lucasexequiel/CEDCp_Modulo_Potencia/Módulo_Potencia_Esquematico.png

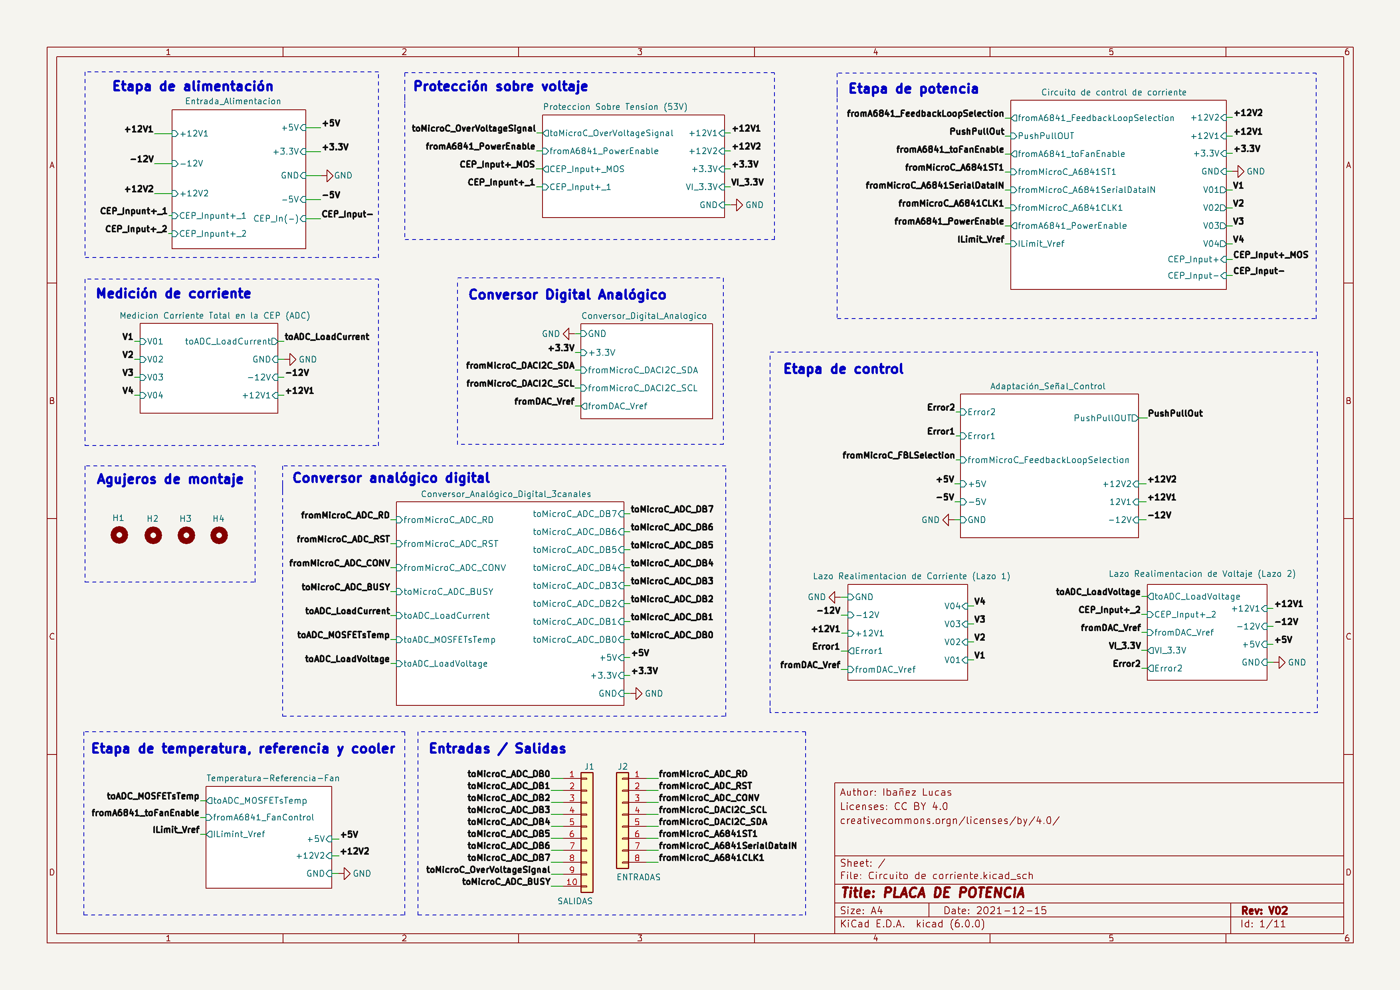
Módulo_Potencia_Esquematico.png
