lucasexequiel/CEDCp_Modulo_Potencia/Gerbers/Circuito de corriente-B_Cu_Page.pdf

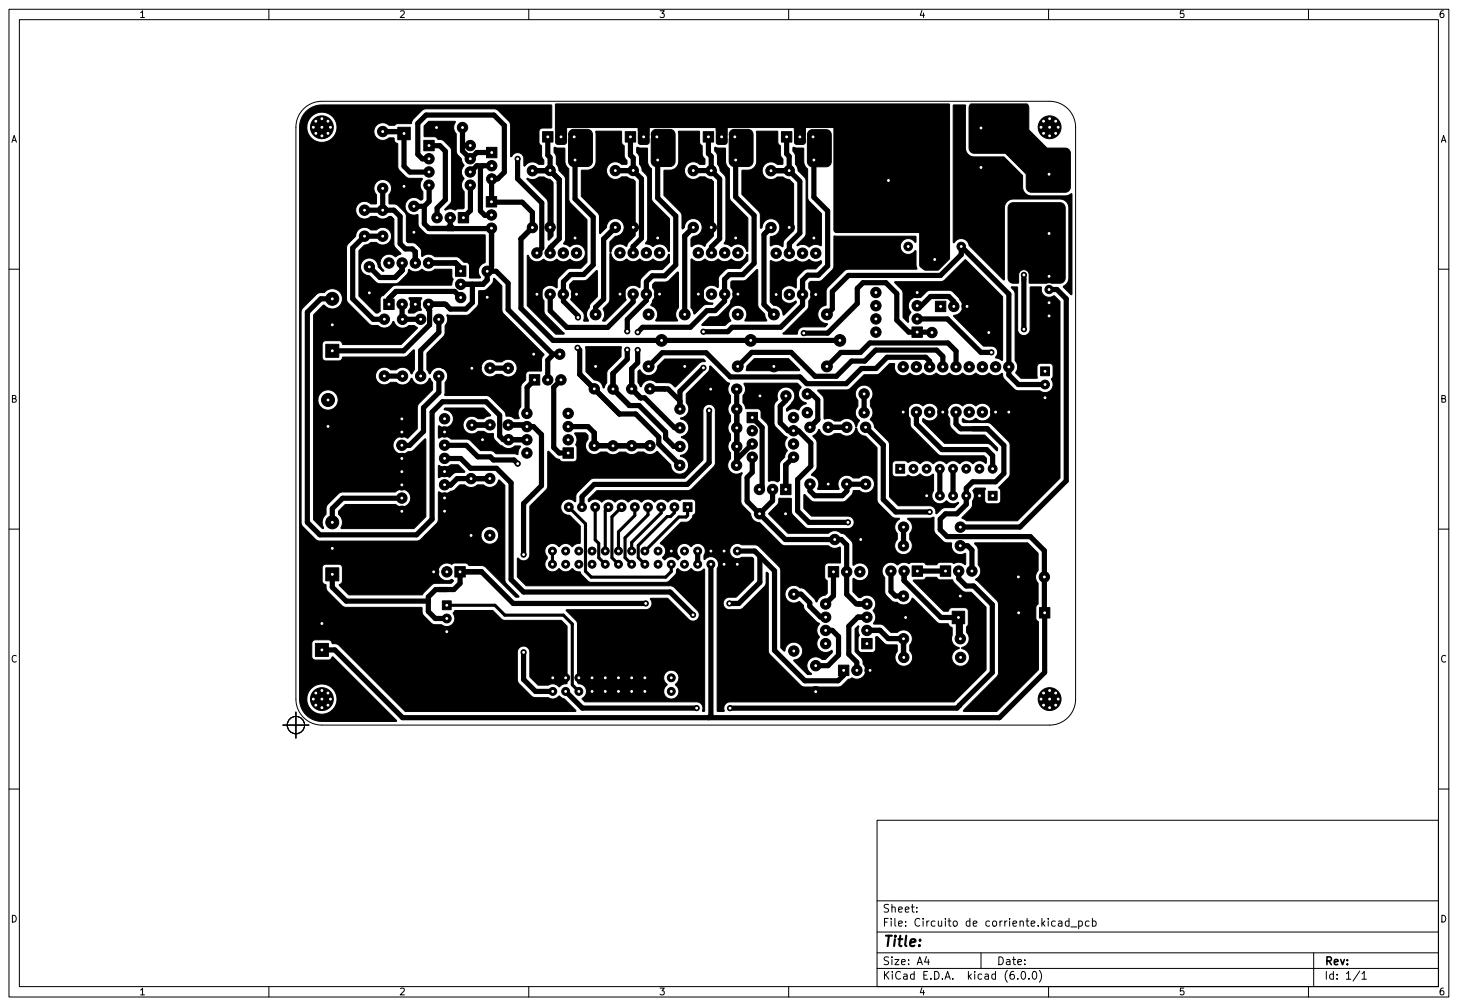
[picture p2: page 1]

File: Circuito de corriente.kicad_pcb Sheet:
Id: 1/1 Title:
