lucasexequiel/CEDCp_Modulo_Potencia/Gerbers/Circuito de corriente-B_Cu_0.pdf

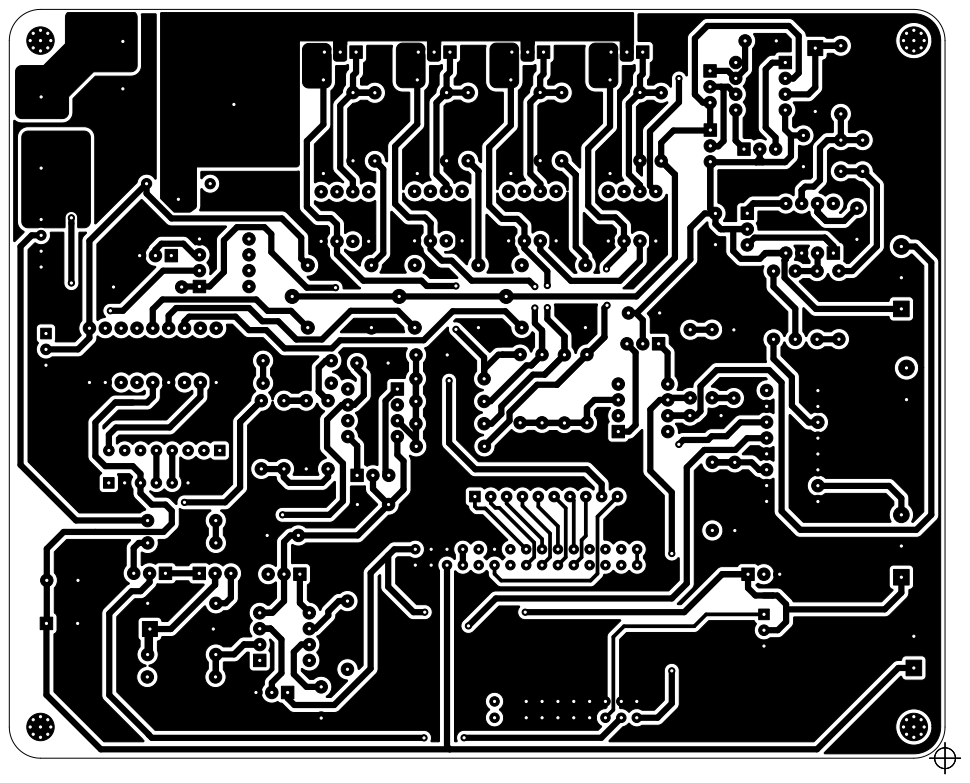
[picture p4: page 1]
