lucasexequiel/CEDCp_Modulo_Potencia/Gerbers/Circuito de corriente-F_Cu_0.pdf

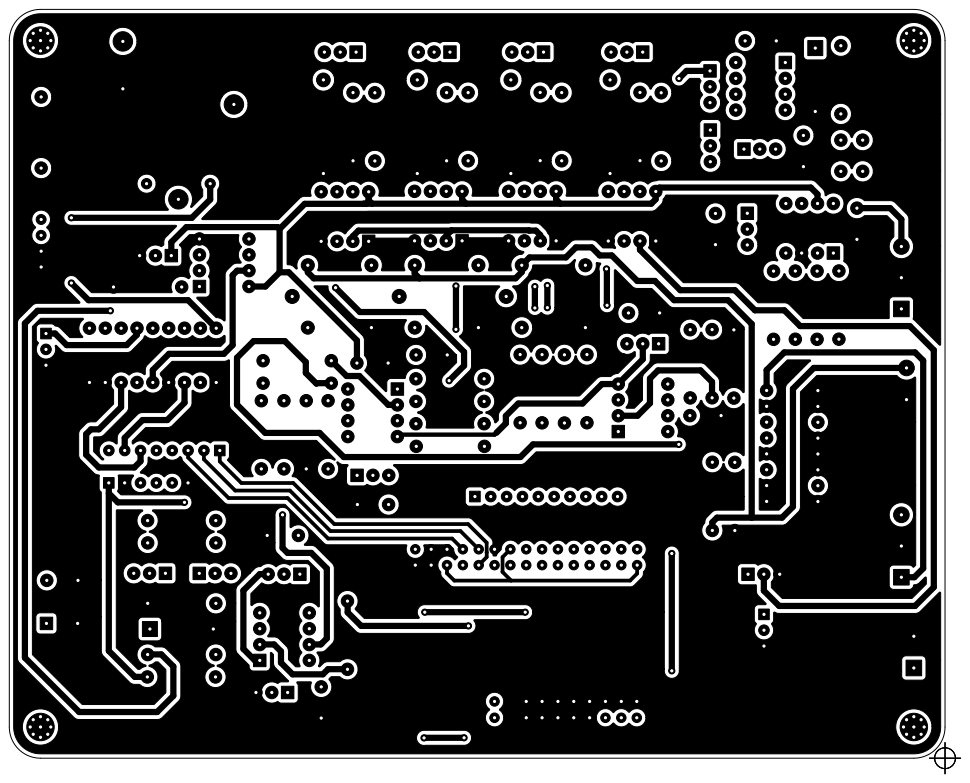
[picture p5: page 1]
