lucasexequiel/CEDCp_Modulo_Potencia/Circuito de corriente.kicad_pcb

## KiCad design Circuito de corriente.kicad_pcb (2022-05-04)

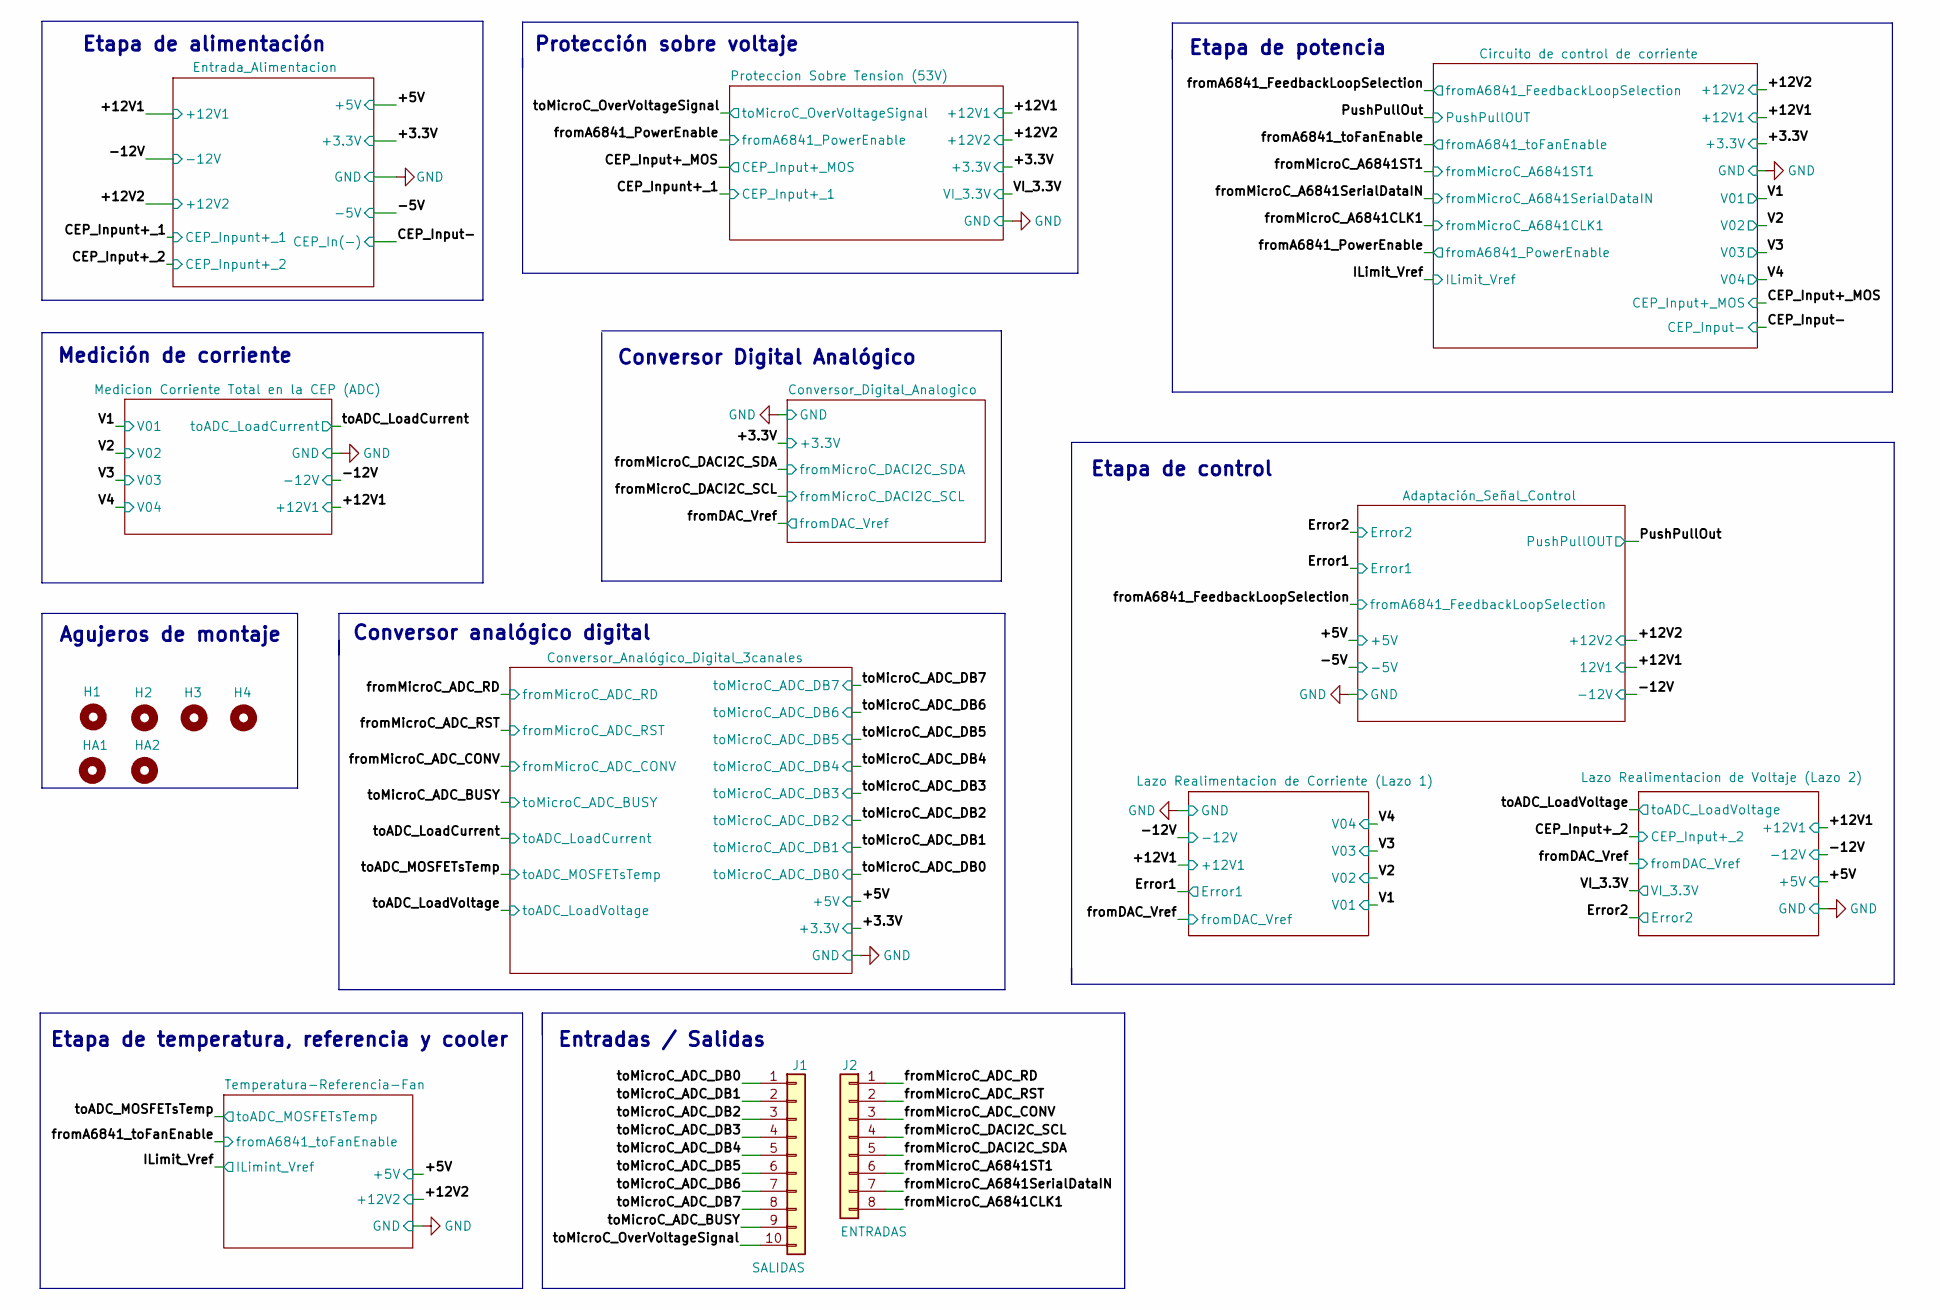
[picture p6: schematic Circuito de corriente.kicad_sch, PLACA DE POTENCIA]

Parts:
H1, H2, H3, H4: MountingHole; MountingHole_2.2mm_M2_Pad_Via
HA1, HA2: MountingHole; MountingHole_2.2mm_M2_Pad_Via
J1: SALIDAS; PinHeader_1x10_P2.54mm_Vertical
J2: ENTRADAS; PinHeader_1x08_P2.54mm_Vertical

Connections:
/fromMicroC_A6841CLK1: J2.8; also elsewhere on the board
/fromMicroC_A6841ST1: J2.6; also elsewhere on the board
/fromMicroC_A6841SerialDataIN: J2.7; also elsewhere on the board
/fromMicroC_ADC_CONV: J2.3; also elsewhere on the board
/fromMicroC_ADC_RD: J2.1; also elsewhere on the board
/fromMicroC_ADC_RST: J2.2; also elsewhere on the board
/fromMicroC_DACI2C_SCL: J2.4; also elsewhere on the board
/fromMicroC_DACI2C_SDA: J2.5; also elsewhere on the board
/toMicroC_ADC_BUSY: J1.9; also elsewhere on the board
/toMicroC_ADC_DB0: J1.1; also elsewhere on the board
/toMicroC_ADC_DB1: J1.2; also elsewhere on the board
/toMicroC_ADC_DB2: J1.3; also elsewhere on the board
/toMicroC_ADC_DB3: J1.4; also elsewhere on the board
/toMicroC_ADC_DB4: J1.5; also elsewhere on the board
/toMicroC_ADC_DB5: J1.6; also elsewhere on the board
/toMicroC_ADC_DB6: J1.7; also elsewhere on the board
/toMicroC_ADC_DB7: J1.8; also elsewhere on the board
/toMicroC_OverVoltageSignal: J1.10; also elsewhere on the board

Notes on the sheet:
Etapa de control
Agujeros de montaje
Etapa de temperatura, referencia y cooler
Protección sobre voltaje
Conversor Digital Analógico
Entradas / Salidas
Conversor analógico digital
Medición de corriente
Etapa de potencia
Etapa de alimentación

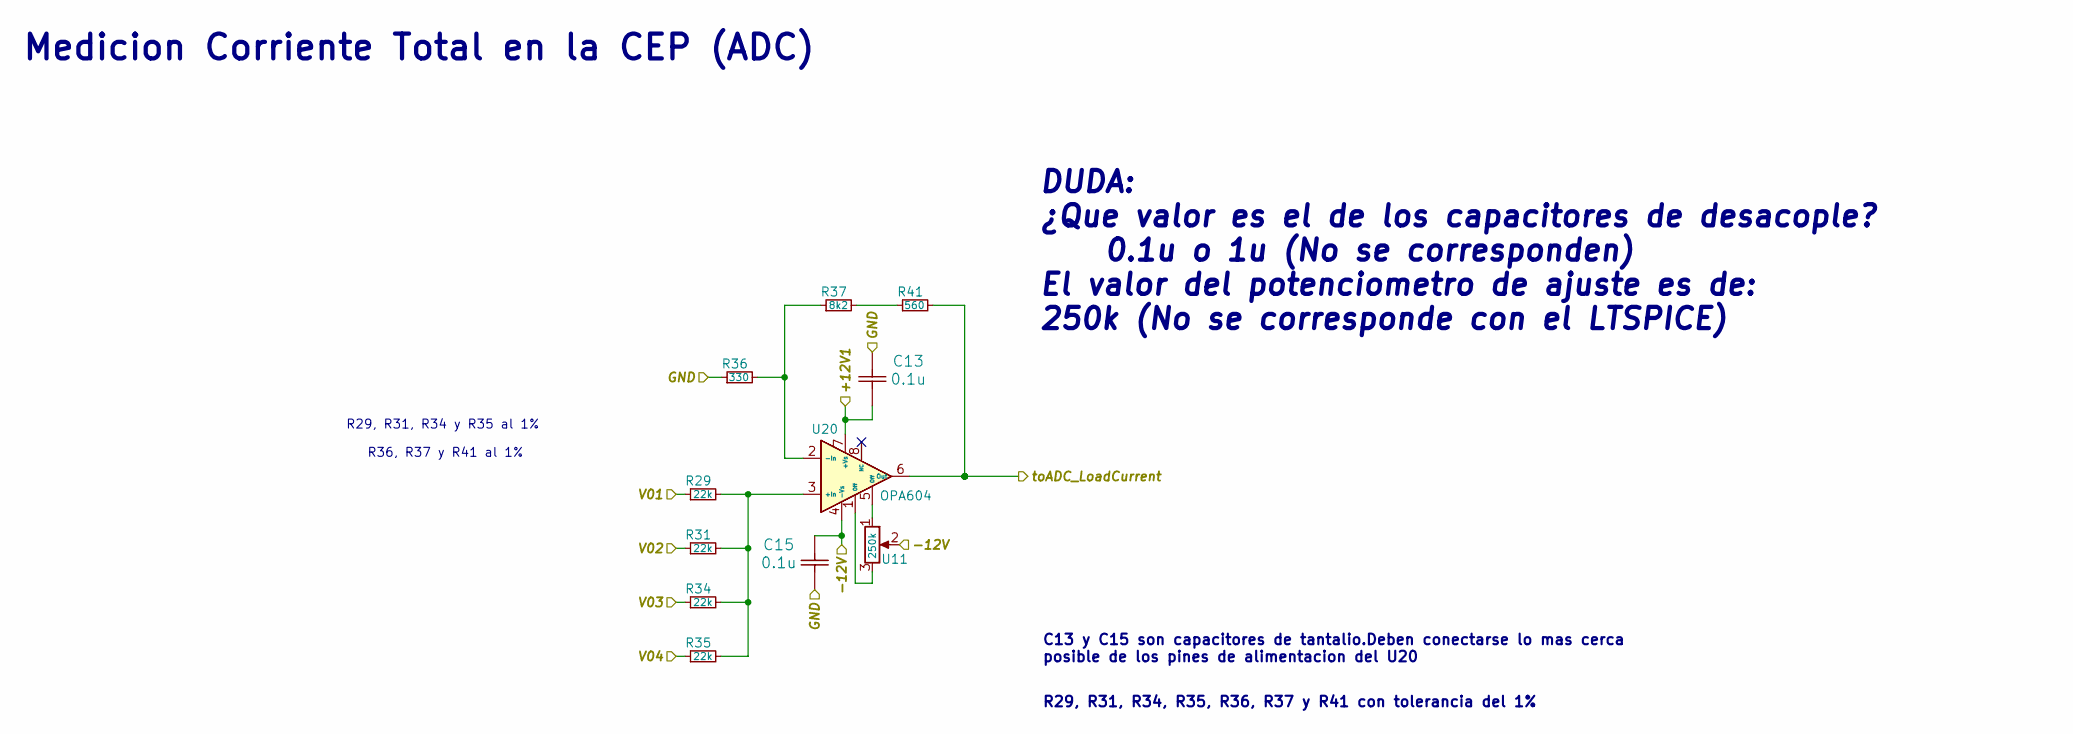
[picture p7: schematic Medicion Corriente Total en la CEP (ADC).kicad_sch]

Parts:
C13, C15: 0.1u; C_Disc_D7.5mm_W2.5mm_P5.00mm
R29, R31, R34, R35: 22k; Resistencia_0,25W
R36: 330; Resistencia_0,25W
R37: 8k2; Resistencia_0,25W
R41: 560; Resistencia_0,25W
U11: 250k; Preset_Multivueltas_Vertical
U20: OPA604

Connections:
/+12V1: C13.2, U20.7 (+Vs); also elsewhere on the board
/V1: R29.1; also elsewhere on the board
/V2: R31.1; also elsewhere on the board
/V3: R34.1; also elsewhere on the board
/V4: R35.1; also elsewhere on the board
/toADC_LoadCurrent: R41.2, U20.6 (Out); also elsewhere on the board
GND: C13.1, C15.2, R36.1; also elsewhere on the board
unnamed: R29.2, R31.2, R34.2, R35.2, U20.3 (+In)
unnamed: R36.2, R37.1, U20.2 (-In)
unnamed: R37.2, R41.1

Notes on the sheet:
R29, R31, R34, R35, R36, R37 y R41 con tolerancia del 1%
DUDA: ¿Que valor es el de los capacitores de desacople? 0.1u o 1u (No se corresponden) El valor del potenciometro de ajuste es de: 250k (No se corresponde con el LTSPICE)
R36, R37 y R41 al 1%
Medicion Corriente Total en la CEP (ADC)
C13 y C15 son capacitores de tantalio.Deben conectarse lo mas cerca posible de los pines de alimentacion del U20
R29, R31, R34 y R35 al 1%

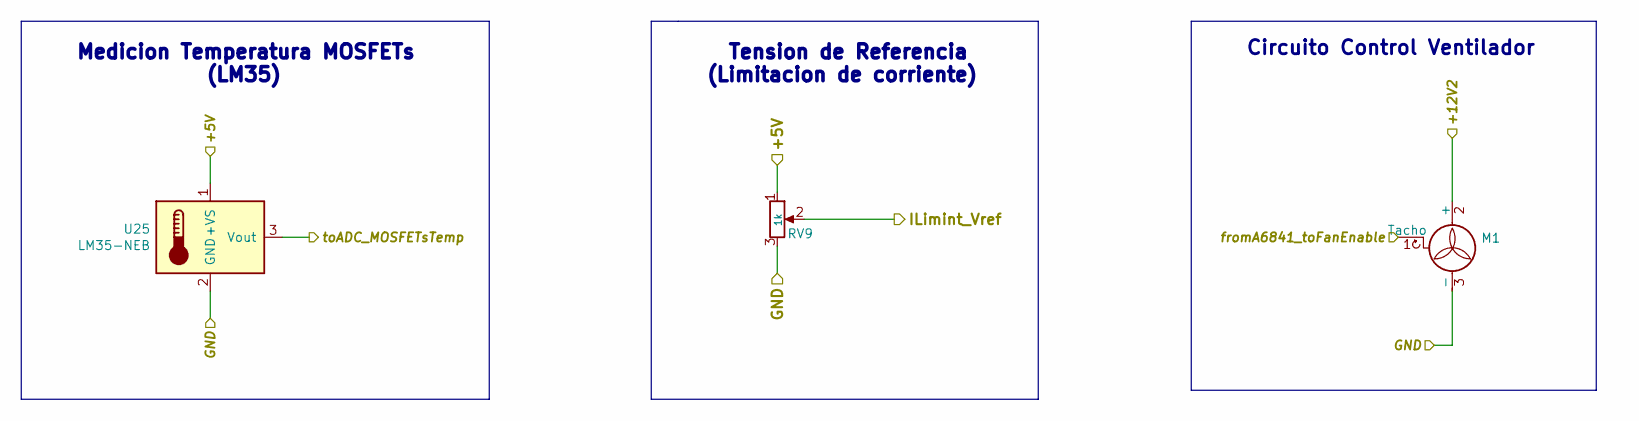
[picture p8: schematic Temperatura-Referencia-Fan.kicad_sch]

Parts:
M1: Fan_3pin; PinHeader_1x03_P2.54mm_Vertical
RV9: 1k; Preset_Multivueltas_Vertical
U25: LM35-NEB; PinHeader_1x03_P2.54mm_Vertical

Connections:
/+5V: RV9.1, U25.1 (+VS); also elsewhere on the board
/+12V2: M1.2 (+); also elsewhere on the board
/ILimit_Vref: RV9.2; also elsewhere on the board
/fromA6841_toFanEnable: M1.1 (Tacho); also elsewhere on the board
/toADC_MOSFETsTemp: U25.3 (Vout); also elsewhere on the board
GND: M1.3 (-), RV9.3, U25.2 (GND); also elsewhere on the board

Notes on the sheet:
Tension de Referencia (Limitacion de corriente)
Medicion Temperatura MOSFETs (LM35)
Circuito Control Ventilador

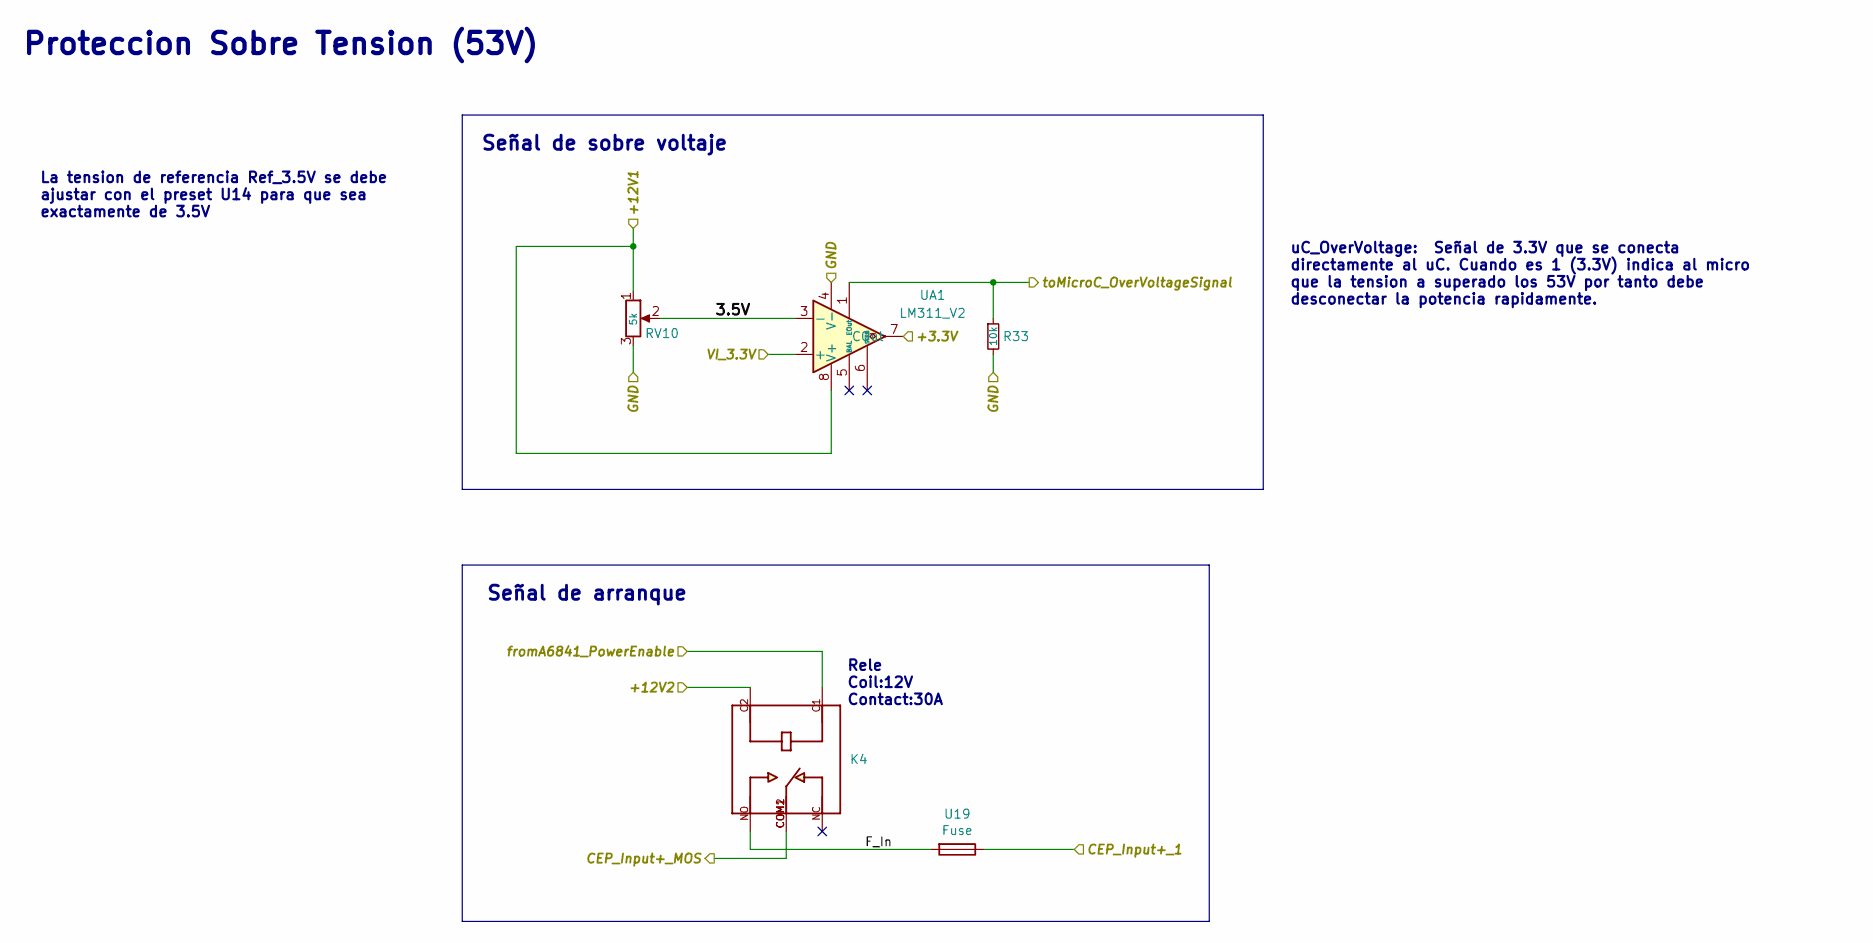
[picture p9: schematic Proteccion Sobre Tension (53V).kicad_sch]

Parts:
K4: SLA-12VDC-SL-C; RELE_30A
R33: 10k; Resistencia_0,25W
RV10: 5k; Preset_Multivueltas_Vertical
U19: Fuse
UA1: LM311_V2

Connections:
/+3.3V: UA1.7 (COut); also elsewhere on the board
/+12V1: RV10.1, UA1.8 (V+); also elsewhere on the board
/+12V2: K4.C2; also elsewhere on the board
/CEP_Inpunt+_1: U19.1; also elsewhere on the board
/CEP_Input+_MOS: K4.COM1, K4.COM2; also elsewhere on the board
/Proteccion Sobre Tension (53V)/3.5V: RV10.2, UA1.3 (-)
/Proteccion Sobre Tension (53V)/F_In: K4.NO, U19.2
/VI_3.3V: UA1.2 (+); also elsewhere on the board
/fromA6841_PowerEnable: K4.C1; also elsewhere on the board
/toMicroC_OverVoltageSignal: R33.1, UA1.1 (EOut); also elsewhere on the board
GND: R33.2, RV10.3, UA1.4 (V-); also elsewhere on the board

Notes on the sheet:
Señal de arranque
La tension de referencia Ref_3.5V se debe ajustar con el preset U14 para que sea exactamente de 3.5V
Rele Coil:12V Contact:30A
Proteccion Sobre Tension (53V)
uC_OverVoltage: Señal de 3.3V que se conecta directamente al uC. Cuando es 1 (3.3V) indica al micro que la tension a superado los 53V por tanto debe desconectar la potencia rapidamente.
Señal de sobre voltaje

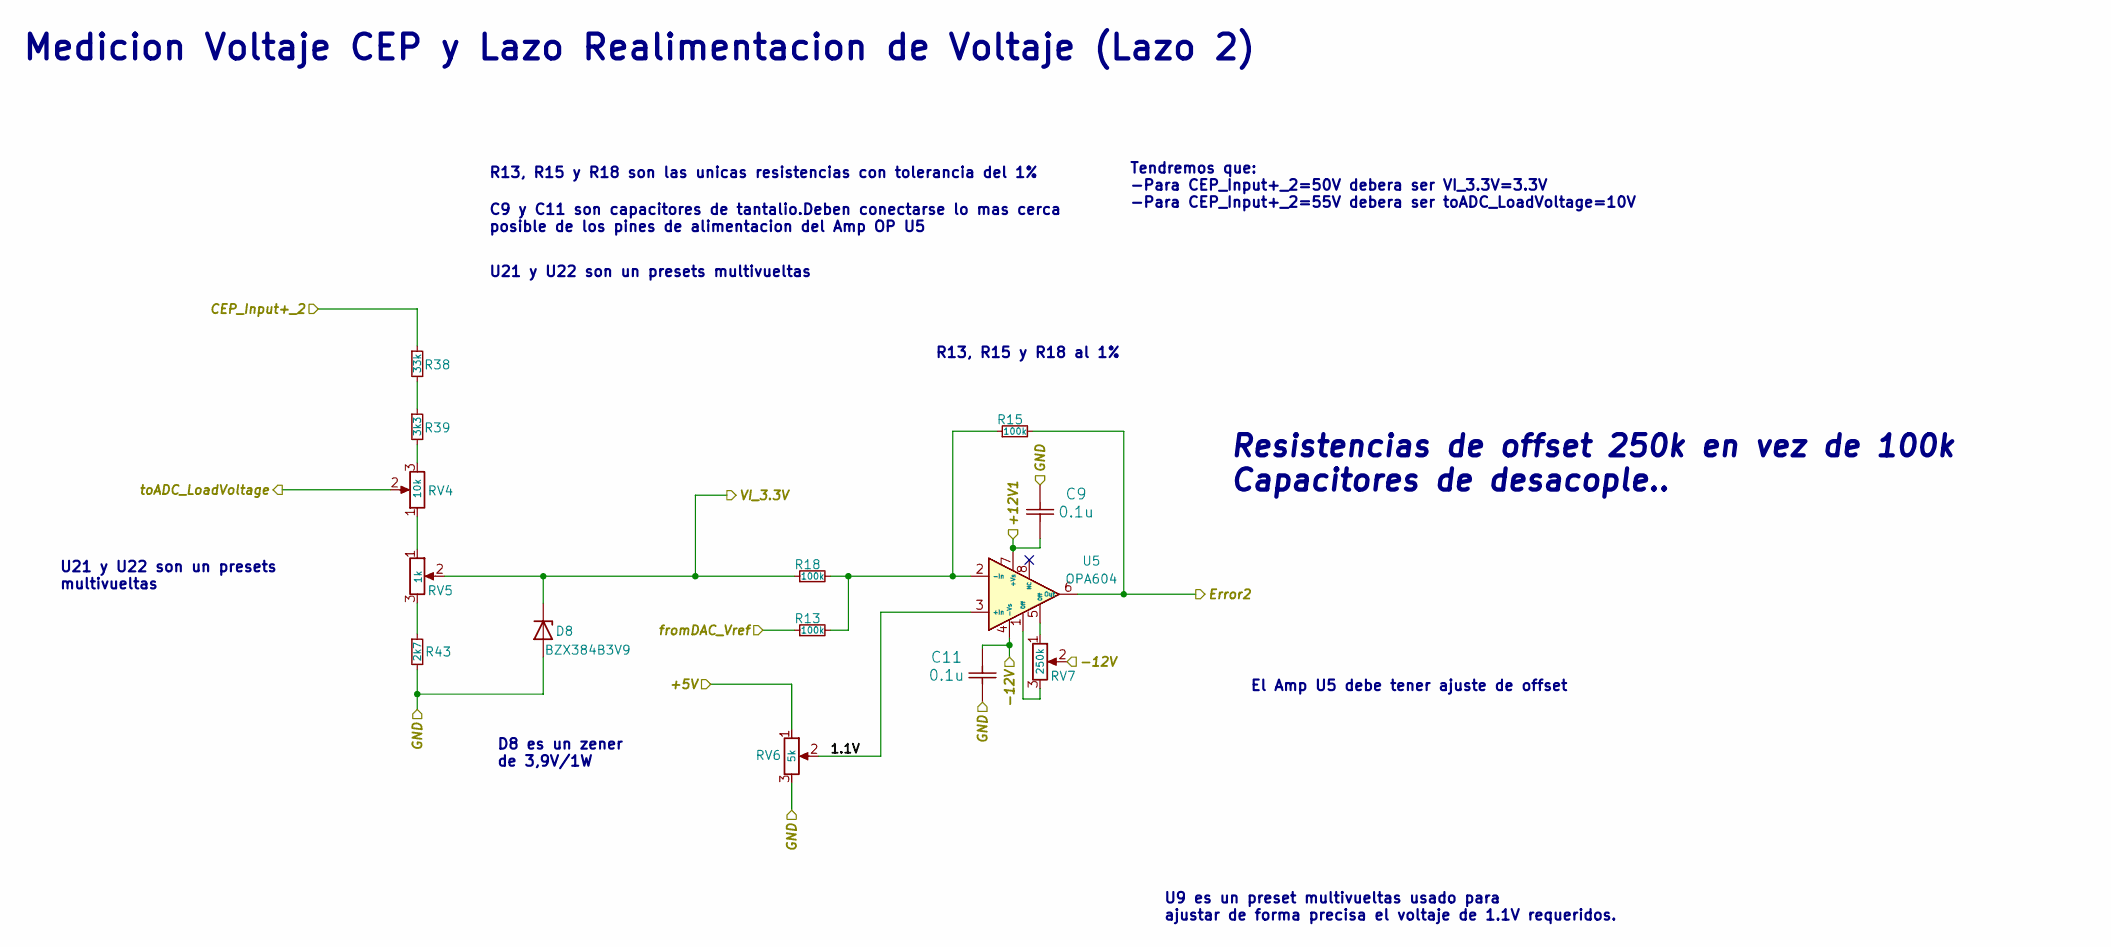
[picture p10: schematic Lazo Realimentacion de Voltaje (Lazo 2).kicad_sch]

Parts:
C9, C11: 0.1u; C_Disc_D7.5mm_W2.5mm_P5.00mm
D8: BZX384B3V9; D_DO-15_P10.16mm_Horizontal
R13, R15, R18: 100k; Resistencia_0,25W
R38: 33k; Resistencia_0,25W
R39: 3k3; Resistencia_0,25W
R43: 2k7; Resistencia_0,25W
RV4: 10k; Preset_Multivueltas_Vertical
RV5: 1k; Preset_Multivueltas_Vertical
RV6: 5k; Preset_Multivueltas_Vertical
RV7: 250k; Preset_Multivueltas_Vertical
U5: OPA604

Connections:
/+5V: RV6.1; also elsewhere on the board
/+12V1: C9.2, U5.7 (+Vs); also elsewhere on the board
/CEP_Input+_2: R38.1; also elsewhere on the board
/Error2: R15.2, U5.6 (Out); also elsewhere on the board
/Lazo Realimentacion de Voltaje (Lazo 2)/1.1V: RV6.2, U5.3 (+In)
/VI_3.3V: D8.1 (K), R18.1, RV5.2; also elsewhere on the board
/fromDAC_Vref: R13.1; also elsewhere on the board
/toADC_LoadVoltage: RV4.2; also elsewhere on the board
GND: C9.1, C11.1, D8.2 (A), R43.2, RV6.3; also elsewhere on the board
unnamed: R13.2, R15.1, R18.2, U5.2 (-In)
unnamed: R38.2, R39.1
unnamed: R39.2, RV4.3
unnamed: R43.1, RV5.3
unnamed: RV4.1, RV5.1
unnamed: RV7.1, U5.5 (Off)
unnamed: RV7.3, U5.1 (Off)

Notes on the sheet:
U9 es un preset multivueltas usado para ajustar de forma precisa el voltaje de 1.1V requeridos.
C9 y C11 son capacitores de tantalio.Deben conectarse lo mas cerca posible de los pines de alimentacion del Amp OP U5
El Amp U5 debe tener ajuste de offset
U21 y U22 son un presets multivueltas
D8 es un zener de 3,9V/1W
R13, R15 y R18 al 1%
Resistencias de offset 250k en vez de 100k Capacitores de desacople..
U21 y U22 son un presets multivueltas
Medicion Voltaje CEP y Lazo Realimentacion de Voltaje (Lazo 2)
Tendremos que: -Para CEP_Input+_2=50V debera ser VI_3.3V=3.3V -Para CEP_Input+_2=55V debera ser toADC_LoadVoltage=10V
R13, R15 y R18 son las unicas resistencias con tolerancia del 1%

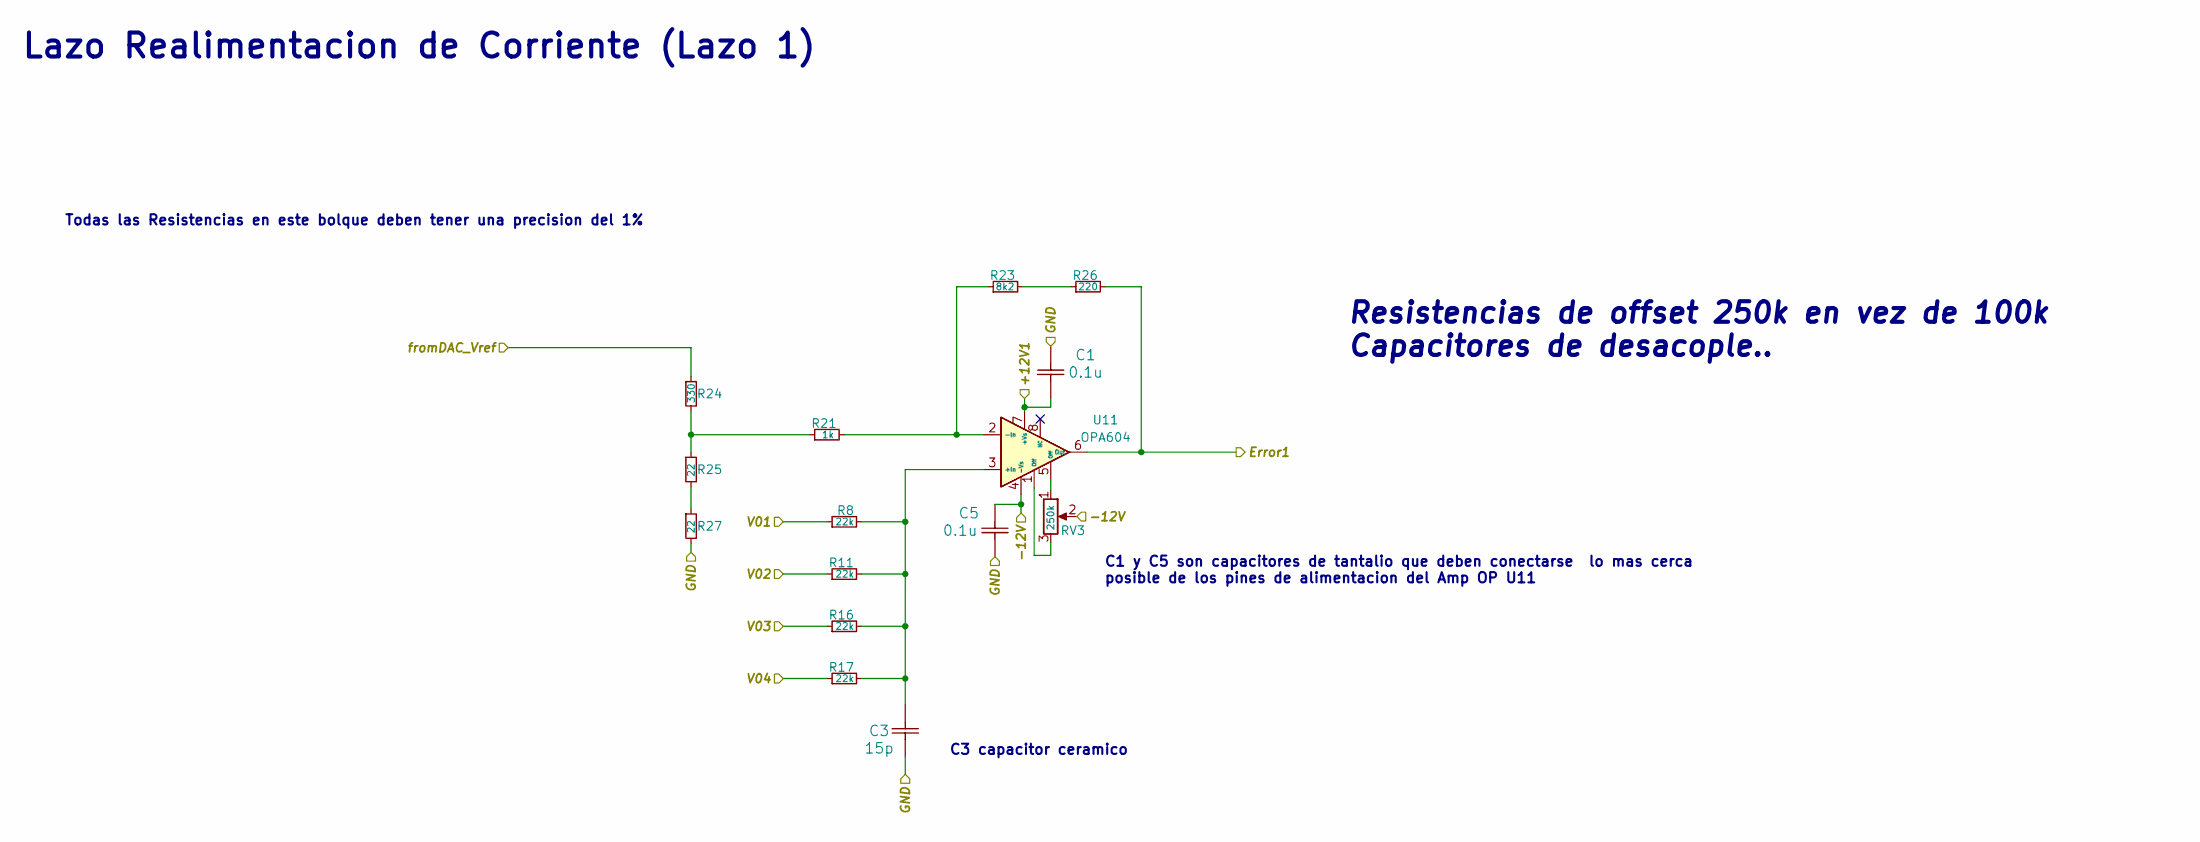
[picture p11: schematic Lazo Realimentacion de Corriente (Lazo 1).kicad_sch]

Parts:
C1, C5: 0.1u; C_Disc_D7.5mm_W2.5mm_P5.00mm
C3: 15p; C_Disc_D7.5mm_W2.5mm_P5.00mm
R8, R11, R16, R17: 22k; Resistencia_0,25W
R21: 1k; Resistencia_0,25W
R23: 8k2; Resistencia_0,25W
R24: 330; Resistencia_0,25W
R25, R27: 22; Resistencia_0,25W
R26: 220; Resistencia_0,25W
RV3: 250k; Preset_Multivueltas_Vertical
U11: OPA604

Connections:
/+12V1: C1.2, U11.7 (+Vs); also elsewhere on the board
/Error1: R26.2, U11.6 (Out); also elsewhere on the board
/V1: R8.1; also elsewhere on the board
/V2: R11.1; also elsewhere on the board
/V3: R16.1; also elsewhere on the board
/V4: R17.1; also elsewhere on the board
/fromDAC_Vref: R24.1; also elsewhere on the board
GND: C1.1, C3.1, C5.2, R27.2; also elsewhere on the board
unnamed: R21.1, R24.2, R25.1
unnamed: R23.2, R26.1
unnamed: R25.2, R27.1
unnamed: RV3.1, U11.5 (Off)

Notes on the sheet:
C3 capacitor ceramico
Resistencias de offset 250k en vez de 100k Capacitores de desacople..
Lazo Realimentacion de Corriente (Lazo 1)
Todas las Resistencias en este bolque deben tener una precision del 1%
C1 y C5 son capacitores de tantalio que deben conectarse lo mas cerca posible de los pines de alimentacion del Amp OP U11

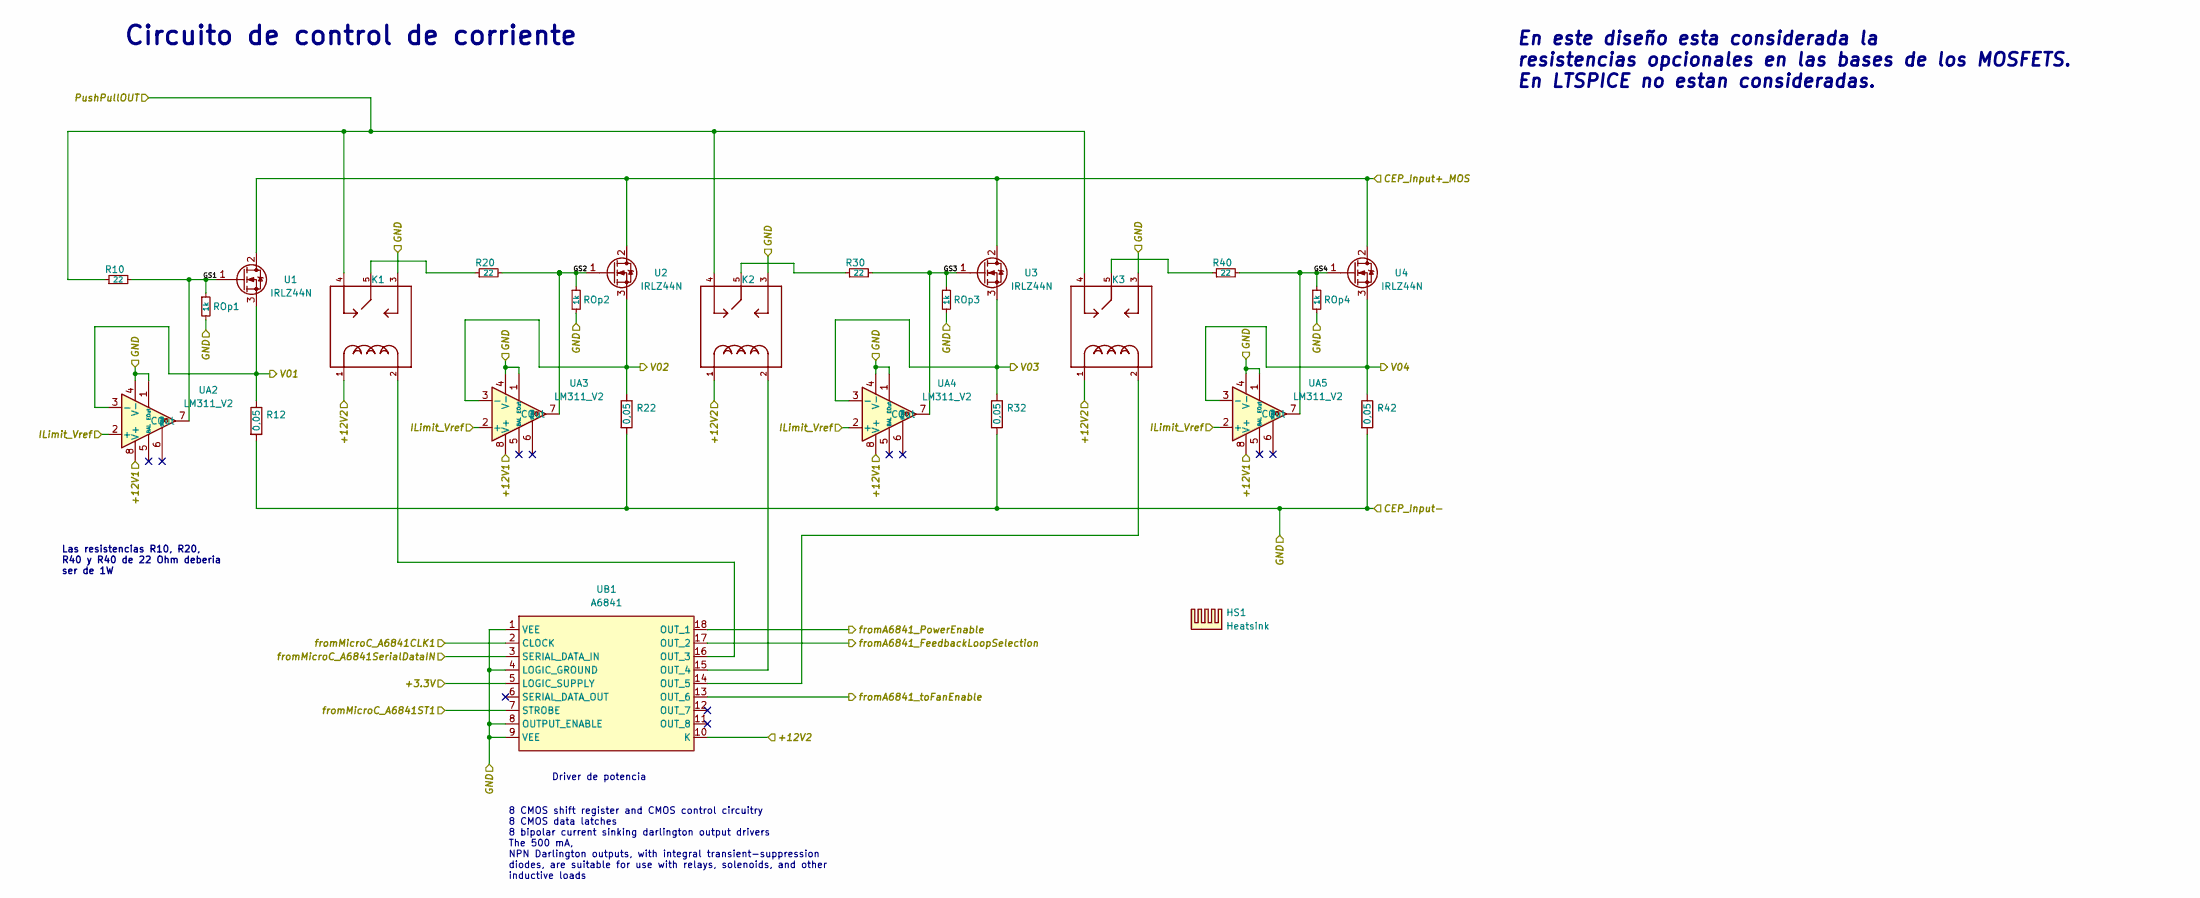
[picture p12: schematic Circuito de control de corriente.kicad_sch]

Parts:
HS1: Heatsink; Heatsink_125x35x50mm_3xFixationM3
K1, K2, K3: JJM1-12V; RELAY_JJM1-12V
R10, R20, R30, R40: 22; Resistencia_0,25W
R12, R22, R32, R42: 0,05; C_Rect_L16.5mm_W4.7mm_P15.00mm_MKT
ROp1, ROp2, ROp3, ROp4: 1k; Resistencia_0,25W
U1, U2, U3, U4: IRLZ44N; TO-220-3_Vertical
UA2, UA3, UA4, UA5: LM311_V2
UB1: A6841

Connections:
/+3.3V: UB1.5 (LOGIC_SUPPLY); also elsewhere on the board
/+12V1: UA2.8 (V+), UA3.8 (V+), UA4.8 (V+), UA5.8 (V+); also elsewhere on the board
/+12V2: K1.1, K2.1, K3.1, UB1.10 (K); also elsewhere on the board
/CEP_Input+_MOS: U1.2 (D), U2.2 (D), U3.2 (D), U4.2 (D); also elsewhere on the board
/Circuito de control de corriente/GS1: R10.2, ROp1.1, U1.1 (G), UA2.7 (COut)
/Circuito de control de corriente/GS2: R20.2, ROp2.1, U2.1 (G), UA3.7 (COut)
/Circuito de control de corriente/GS3: R30.2, ROp3.1, U3.1 (G), UA4.7 (COut)
/Circuito de control de corriente/GS4: R40.2, ROp4.1, U4.1 (G), UA5.7 (COut)
/ILimit_Vref: UA2.2 (+), UA3.2 (+), UA4.2 (+), UA5.2 (+); also elsewhere on the board
/PushPullOut: K1.4 (NC), K2.4 (NC), K3.4 (NC), R10.1; also elsewhere on the board
/V1: R12.1, U1.3 (S), UA2.3 (-); also elsewhere on the board
/V2: R22.1, U2.3 (S), UA3.3 (-); also elsewhere on the board
/V3: R32.1, U3.3 (S), UA4.3 (-); also elsewhere on the board
/V4: R42.1, U4.3 (S), UA5.3 (-); also elsewhere on the board
/fromA6841_FeedbackLoopSelection: UB1.17 (OUT_2); also elsewhere on the board
/fromA6841_PowerEnable: UB1.18 (OUT_1); also elsewhere on the board
/fromA6841_toFanEnable: UB1.13 (OUT_6); also elsewhere on the board
/fromMicroC_A6841CLK1: UB1.2 (CLOCK); also elsewhere on the board
/fromMicroC_A6841ST1: UB1.7 (STROBE); also elsewhere on the board
/fromMicroC_A6841SerialDataIN: UB1.3 (SERIAL_DATA_IN); also elsewhere on the board
GND: K1.3 (NO), K2.3 (NO), K3.3 (NO), R12.2, R22.2, R32.2, R42.2, ROp1.2, ROp2.2, ROp3.2, ROp4.2, UA2.1 (EOut), UA2.4 (V-), UA3.1 (EOut), UA3.4 (V-), UA4.1 (EOut), UA4.4 (V-), UA5.1 (EOut), UA5.4 (V-), UB1.1 (VEE), UB1.4 (LOGIC_GROUND), UB1.8 (OUTPUT_ENABLE), UB1.9 (VEE); also elsewhere on the board
unnamed: K1.2, UB1.16 (OUT_3)
unnamed: K1.5 (C), R20.1
unnamed: K2.2, UB1.15 (OUT_4)
unnamed: K2.5 (C), R30.1
unnamed: K3.2, UB1.14 (OUT_5)
unnamed: K3.5 (C), R40.1

Notes on the sheet:
Driver de potencia
8 CMOS shift register and CMOS control circuitry 8 CMOS data latches 8 bipolar current sinking darlington output drivers The 500 mA, NPN Darlington outputs, with integral transient-suppression diodes, are suitable for use with relays, solenoids, and other inductive loads
Circuito de control de corriente
Las resistencias R10, R20, R40 y R40 de 22 Ohm deberia ser de 1W
En este diseño esta considerada la resistencias opcionales en las bases de los MOSFETS. En LTSPICE no estan consideradas.

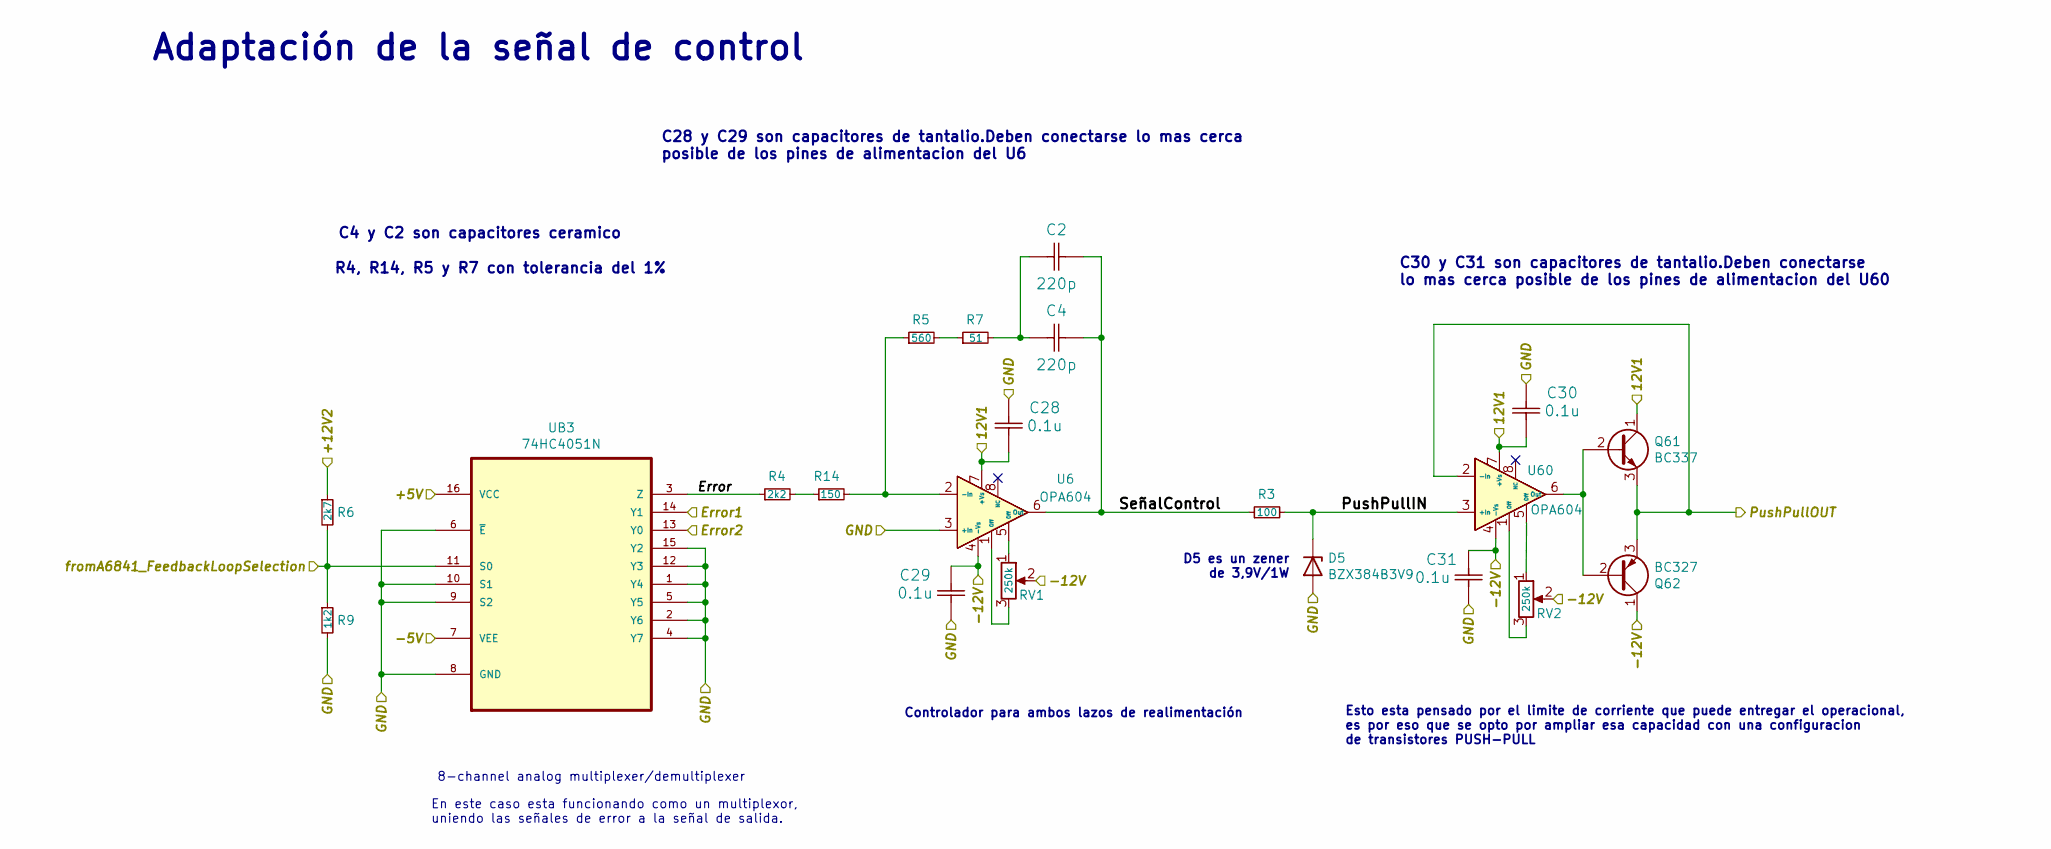
[picture p13: schematic Adaptación_Señal_Control.kicad_sch]

Parts:
C2, C4: 220p; C_Disc_D7.5mm_W2.5mm_P5.00mm
C28, C29, C30, C31: 0.1u; C_Disc_D7.5mm_W2.5mm_P5.00mm
D5: BZX384B3V9; D_DO-41_SOD81_P10.16mm_Horizontal
Q61: BC337; TO-92_Inline
Q62: BC327; TO-92_Inline
R3: 100; Resistencia_0,25W
R4: 2k2; Resistencia_0,25W
R5: 560; Resistencia_0,25W
R6: 2k7; Resistencia_0,25W
R7: 51; Resistencia_0,25W
R9: 1k2; Resistencia_0,25W
R14: 150; Resistencia_0,25W
RV1, RV2: 250k; Preset_Multivueltas_Vertical
U6, U60: OPA604
UB3: 74HC4051N; 74HC4051M; MPN 74HC4051N,652

Connections:
/+5V: UB3.16 (VCC); also elsewhere on the board
/+12V1: C28.2, C30.2, Q61.1 (C), U6.7 (+Vs), U60.7 (+Vs); also elsewhere on the board
/+12V2: R6.1; also elsewhere on the board
/-5V: UB3.7 (VEE); also elsewhere on the board
/Adaptación_Señal_Control/Error: R4.1, UB3.3 (Z)
/Adaptación_Señal_Control/PushPullIN: D5.1 (K), R3.2, U60.3 (+In)
/Adaptación_Señal_Control/SeñalControl: C2.1, C4.1, R3.1, U6.6 (Out)
/Error1: UB3.14 (Y1); also elsewhere on the board
/Error2: UB3.13 (Y0); also elsewhere on the board
/PushPullOut: Q61.3 (E), Q62.3 (E), U60.2 (-In); also elsewhere on the board
/fromA6841_FeedbackLoopSelection: R6.2, R9.1, UB3.11 (S0); also elsewhere on the board
GND: C28.1, C29.2, C30.1, C31.2, D5.2 (A), R9.2, U6.3 (+In), UB3.1 (Y4), UB3.2 (Y6), UB3.4 (Y7), UB3.5 (Y5), UB3.6 (~E), UB3.8 (GND), UB3.9 (S2), UB3.10 (S1), UB3.12 (Y3), UB3.15 (Y2); also elsewhere on the board
unnamed: C2.2, C4.2, R7.2
unnamed: Q61.2 (B), Q62.2 (B), U60.6 (Out)
unnamed: R5.2, R7.1
unnamed: R4.2, R14.1
unnamed: R5.1, R14.2, U6.2 (-In)
unnamed: RV1.1, U6.5 (Off)
unnamed: RV1.3, U6.1 (Off)
unnamed: RV2.1, U60.5 (Off)
unnamed: RV2.3, U60.1 (Off)

Notes on the sheet:
C28 y C29 son capacitores de tantalio.Deben conectarse lo mas cerca posible de los pines de alimentacion del U6
8-channel analog multiplexer/demultiplexer
R4, R14, R5 y R7 con tolerancia del 1%
C30 y C31 son capacitores de tantalio.Deben conectarse lo mas cerca posible de los pines de alimentacion del U60
D5 es un zener de 3,9V/1W
Adaptación de la señal de control
Esto esta pensado por el limite de corriente que puede entregar el operacional, es por eso que se opto por ampliar esa capacidad con una configuracion de transistores PUSH-PULL
Controlador para ambos lazos de realimentación
C4 y C2 son capacitores ceramico
En este caso esta funcionando como un multiplexor, uniendo las señales de error a la señal de salida.
