lucasexequiel/CEDCp_Modulo_Potencia/Circuito de corriente.kicad_pcb

## KiCad design Circuito de corriente.kicad_pcb (continued)

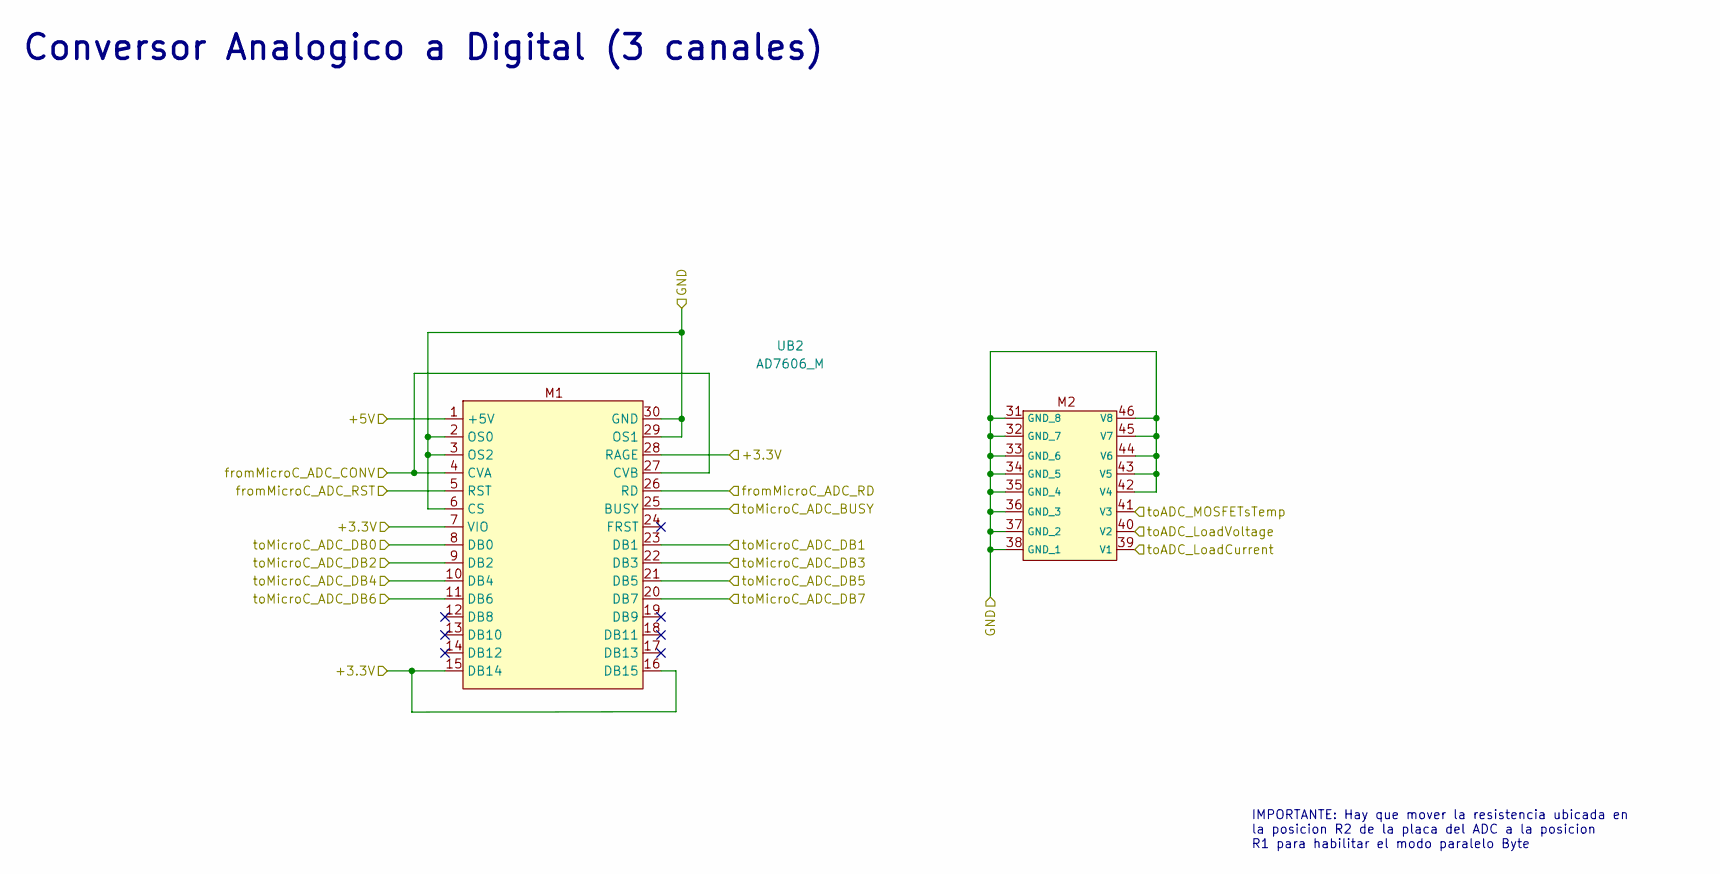
[picture p14: schematic Conversor_Analógico_Digital_3canales.kicad_sch]

Parts:
UB2: AD7606_M

Connections:
/+3.3V: UB2.7 (VIO), UB2.15 (DB14), UB2.16 (DB15), UB2.28 (RAGE); also elsewhere on the board
/+5V: UB2.1 (+5V); also elsewhere on the board
/fromMicroC_ADC_CONV: UB2.4 (CVA), UB2.27 (CVB); also elsewhere on the board
/fromMicroC_ADC_RD: UB2.26 (RD); also elsewhere on the board
/fromMicroC_ADC_RST: UB2.5 (RST); also elsewhere on the board
/toADC_LoadCurrent: UB2.39 (V1); also elsewhere on the board
/toADC_LoadVoltage: UB2.40 (V2); also elsewhere on the board
/toADC_MOSFETsTemp: UB2.41 (V3); also elsewhere on the board
/toMicroC_ADC_BUSY: UB2.25 (BUSY); also elsewhere on the board
/toMicroC_ADC_DB0: UB2.8 (DB0); also elsewhere on the board
/toMicroC_ADC_DB1: UB2.23 (DB1); also elsewhere on the board
/toMicroC_ADC_DB2: UB2.9 (DB2); also elsewhere on the board
/toMicroC_ADC_DB3: UB2.22 (DB3); also elsewhere on the board
/toMicroC_ADC_DB4: UB2.10 (DB4); also elsewhere on the board
/toMicroC_ADC_DB5: UB2.21 (DB5); also elsewhere on the board
/toMicroC_ADC_DB6: UB2.11 (DB6); also elsewhere on the board
/toMicroC_ADC_DB7: UB2.20 (DB7); also elsewhere on the board
GND: UB2.2 (OS0), UB2.3 (OS2), UB2.6 (CS), UB2.29 (OS1), UB2.30 (GND), UB2.31 (GND_8), UB2.32 (GND_7), UB2.33 (GND_6), UB2.34 (GND_5), UB2.35 (GND_4), UB2.36 (GND_3), UB2.37 (GND_2), UB2.38 (GND_1), UB2.42 (V4), UB2.43 (V5), UB2.44 (V6), UB2.45 (V7), UB2.46 (V8); also elsewhere on the board

Notes on the sheet:
IMPORTANTE: Hay que mover la resistencia ubicada en la posicion R2 de la placa del ADC a la posicion R1 para habilitar el modo paralelo Byte
Conversor Analogico a Digital (3 canales)

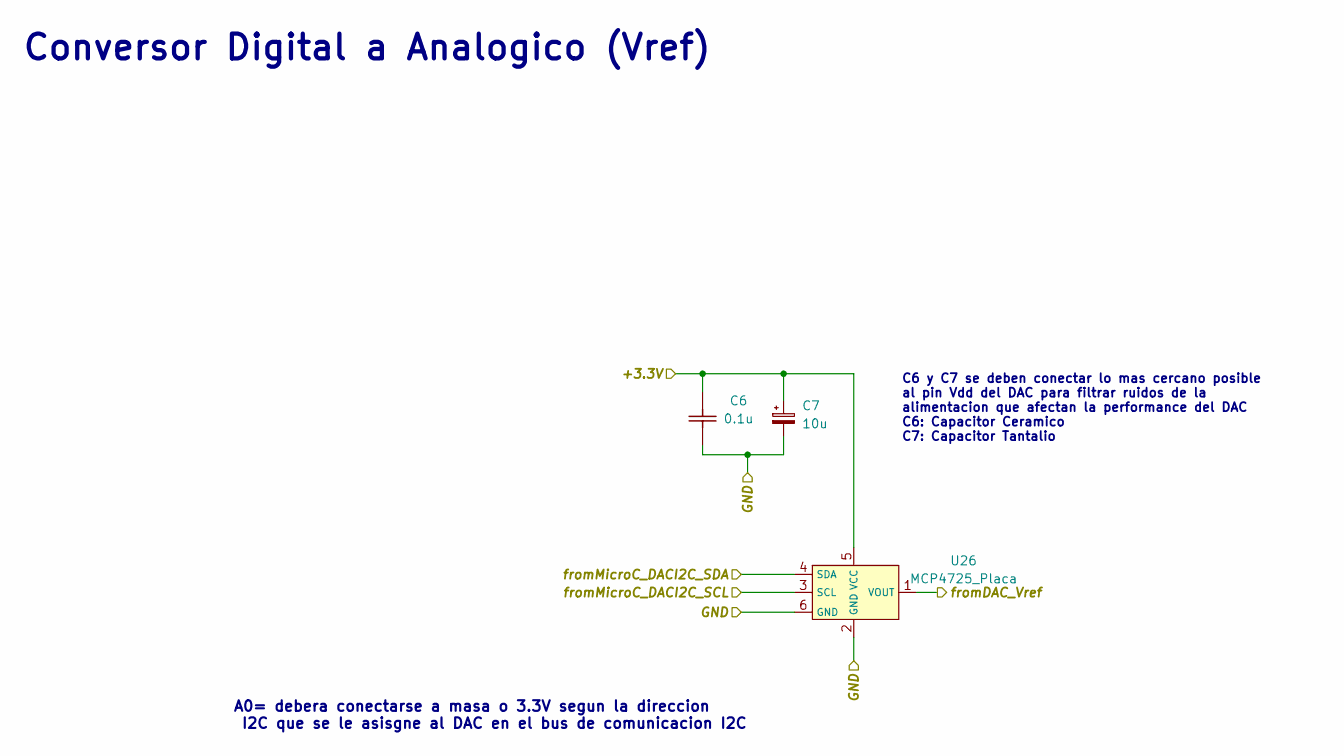
[picture p15: schematic Conversor_Digital_Analogico.kicad_sch]

Parts:
C6: 0.1u; C_Disc_D7.5mm_W2.5mm_P5.00mm
C7: 10u; CP_Radial_D4.0mm_P2.00mm
U26: MCP4725_Placa

Connections:
/+3.3V: C6.1, C7.1, U26.5 (VCC); also elsewhere on the board
/fromDAC_Vref: U26.1 (VOUT); also elsewhere on the board
/fromMicroC_DACI2C_SCL: U26.3 (SCL); also elsewhere on the board
/fromMicroC_DACI2C_SDA: U26.4 (SDA); also elsewhere on the board
GND: C6.2, C7.2, U26.2 (GND), U26.6 (GND); also elsewhere on the board

Notes on the sheet:
A0= debera conectarse a masa o 3.3V segun la direccion I2C que se le asisgne al DAC en el bus de comunicacion I2C
C6 y C7 se deben conectar lo mas cercano posible al pin Vdd del DAC para filtrar ruidos de la alimentacion que afectan la performance del DAC C6: Capacitor Ceramico C7: Capacitor Tantalio
Conversor Digital a Analogico (Vref)

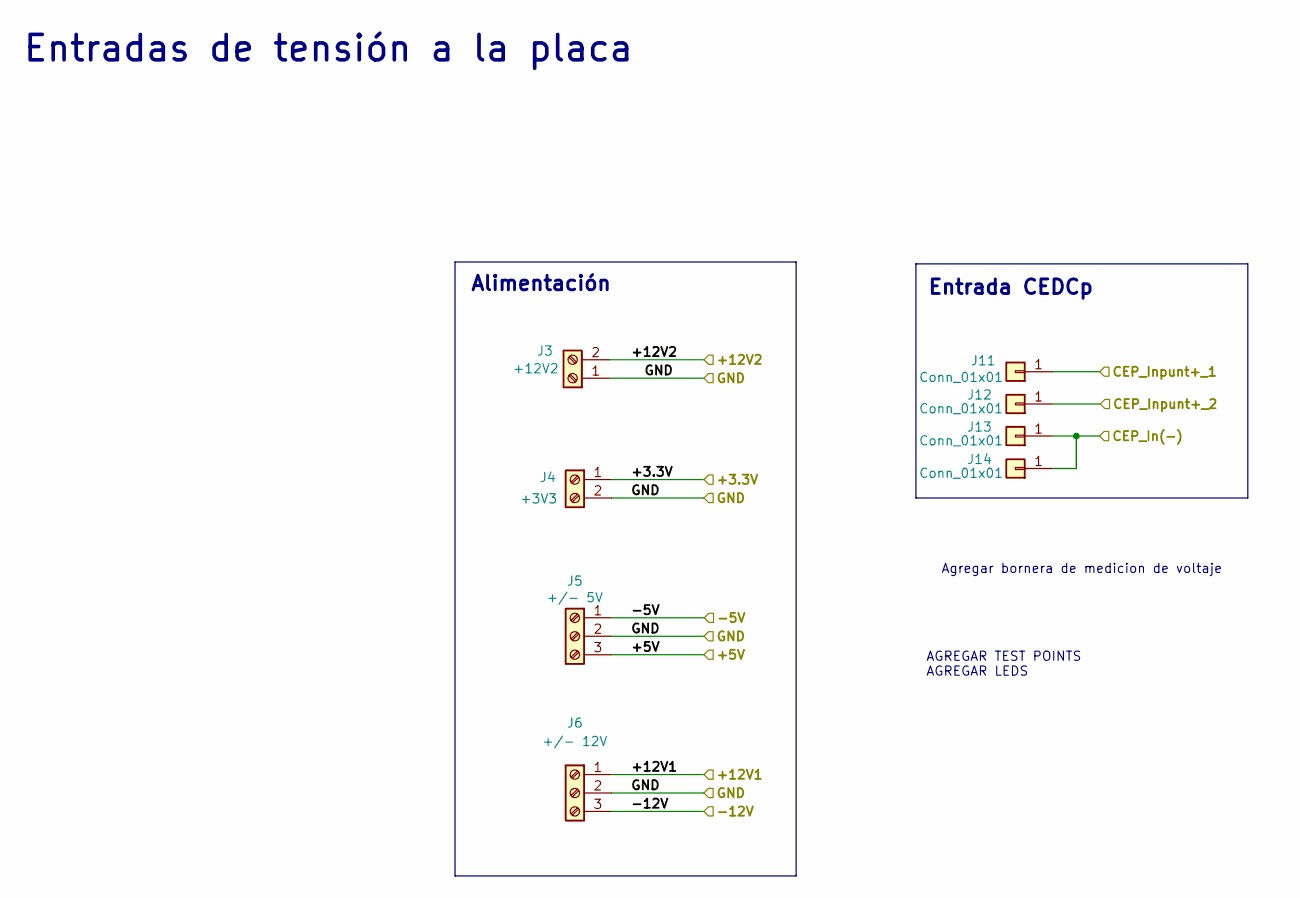
[picture p16: schematic Entrada_Alimentacion.kicad_sch]

Parts:
J3: +12V2; Bornera_1x2
J4: +3V3; Bornera_1x2
J5: +/- 5V; Bornera_1x3
J6: +/- 12V; Bornera_1x3
J11, J13: Conn_01x01; SolderWire-2sqmm_1x01_D2mm_OD3.9mm
J12, J14: Conn_01x01; SolderWire-0.5sqmm_1x01_D0.9mm_OD2.3mm

Connections:
/+3.3V: J4.1; also elsewhere on the board
/+5V: J5.3; also elsewhere on the board
/+12V1: J6.1; also elsewhere on the board
/+12V2: J3.2; also elsewhere on the board
/-5V: J5.1; also elsewhere on the board
/CEP_Inpunt+_1: J11.1; also elsewhere on the board
/CEP_Input+_2: J12.1; also elsewhere on the board
GND: J3.1, J4.2, J5.2, J6.2, J13.1, J14.1; also elsewhere on the board

Notes on the sheet:
Agregar bornera de medicion de voltaje
Alimentación
Entradas de tensión a la placa
Entrada CEDCp
AGREGAR TEST POINTS AGREGAR LEDS

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
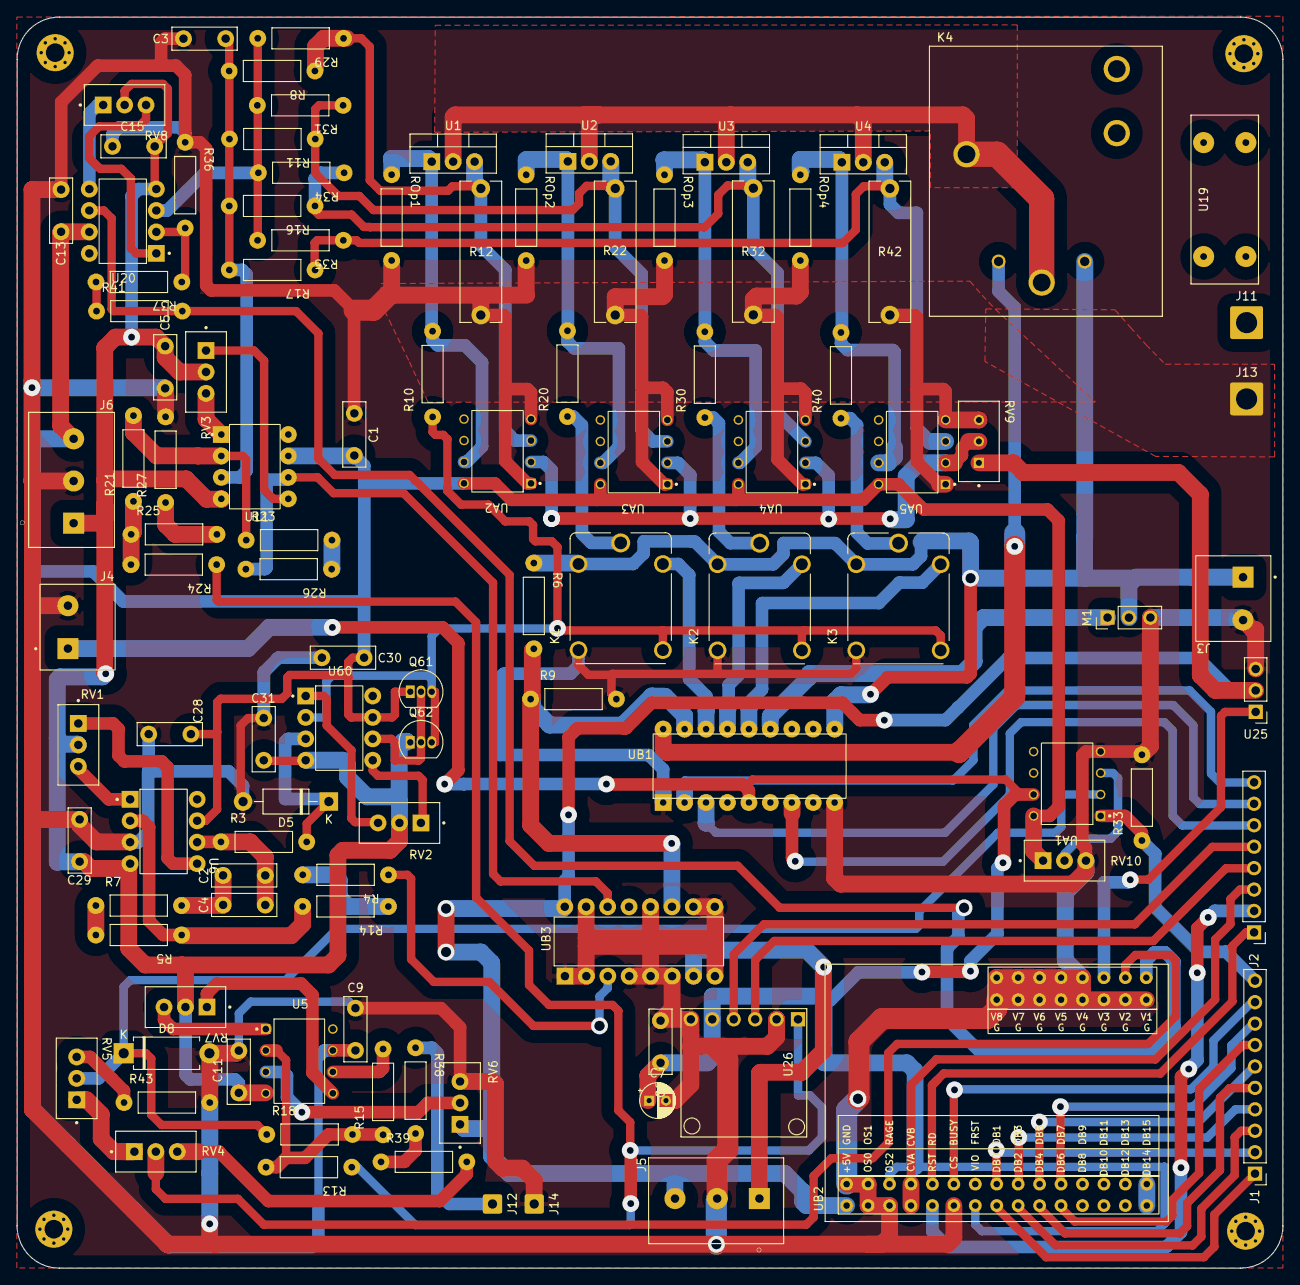
[picture p17: board Circuito de corriente.kicad_pcb from above]

Board: 2 copper layers, 150.0 x 148.2 mm, 112 parts (0 on the bottom side), 88 nets.

Other parts of the board:
RV8: 250k; Preset_Multivueltas_Vertical
