lucasexequiel/CEDCp_Modulo_Potencia/(commit log)

2022-02-05 Added Kicad files Modulo de potencia
    [Adaptación_Señal_Control.kicad_sch, Adaptación_Señal_Control.sch, Circuito Control Ventilador.kicad_sch, Circuito Control Ventilador.sch, Circuito de control de corriente.kicad_sch, Circuito de control de corriente.sch, Circuito de corriente.kicad_pcb, Circuito de corriente.kicad_sch]
2022-02-11 Added 3D model
    [Circuito de corriente.kicad_pcb]
2022-02-12 Gerbers files generated
    [Circuito de corriente-B_Cu.gbr, Circuito de corriente-B_Mask.gbr, Circuito de corriente-B_Paste.gbr, Circuito de corriente-B_Silkscreen.gbr, Circuito de corriente-Edge_Cuts.gbr, Circuito de corriente-F_Cu.gbr, Circuito de corriente-F_Mask.gbr, Circuito de corriente-F_Paste.gbr]
2022-02-18 Reorder conection with control module
    [Adaptación_Señal_Control.kicad_sch, Circuito de control de corriente.kicad_sch, Circuito de corriente.kicad_pcb, Circuito de corriente.kicad_sch, Conversor_Analógico_Digital_3canales.kicad_sch, Conversor_Digital_Analogico.kicad_sch, Entrada_Alimentacion.kicad_sch, Lazo Realimentacion de Corriente (Lazo 1).kicad_sch]
2022-02-28 Gerbers generated again
    [Adaptación_Señal_Control.kicad_sch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]
2022-03-06 Version V1 (Clearence + pads)
    [Adaptación_Señal_Control.kicad_sch, Circuito de control de corriente.kicad_sch, Circuito de corriente.kicad_pcb, Circuito de corriente.kicad_sch, Conversor_Analógico_Digital_3canales.kicad_sch, Conversor_Digital_Analogico.kicad_sch]
2022-03-15 Origin added
    [Circuito de corriente.kicad_pcb]
2022-03-21 Heat sink added + Large pads
    [Adaptación_Señal_Control.kicad_sch, Circuito de control de corriente.kicad_sch, Circuito de corriente.kicad_pcb, Circuito de corriente.kicad_sch, Conversor_Analógico_Digital_3canales.kicad_sch]
2022-04-16 Pads mas grandes y correccion de vias
    [Adaptación_Señal_Control.kicad_sch, Circuito de control de corriente.kicad_sch, Circuito de corriente.kicad_pcb, Circuito de corriente.kicad_sch, Lazo Realimentacion de Voltaje (Lazo 2).kicad_sch, Proteccion Sobre Tension (53V).kicad_sch, Temperatura-Referencia-Fan.kicad_sch]
2022-04-20 Se agrandaron los pads de las VIAS y ensancharon las pistas
    [Circuito de corriente.kicad_pcb]
2022-05-04 V4 Ltspice
    [Adaptación_Señal_Control.kicad_sch, Circuito de control de corriente.kicad_sch, Circuito de corriente.kicad_pcb, Circuito de corriente.kicad_sch, Conversor_Analógico_Digital_3canales.kicad_sch, Conversor_Digital_Analogico.kicad_sch, Entrada_Alimentacion.kicad_sch, Lazo Realimentacion de Corriente (Lazo 1).kicad_sch]
2022-05-04 VF4 actualizaciones
    [Adaptación_Señal_Control.kicad_sch]
