lucasexequiel/CEDCp_Modulo_Potencia/(notices)

Notices in the files:
Circuito de corriente.sch:
creativecommons.orgn/licenses/by/4.0
Licenses: CC BY 4.0
Circuito de control de corriente.kicad_sch:
License: CC BY 4.0
